JH2k00/BioSensorBox/README.md

# BioSensorBox
This repository contains the hardware and software for my project in the Advanced Topics in PCB Design lecture at the Technical University of Darmstadt
