JH2k00/BioSensorBox/biosensorbox/schematic_v11.pdf

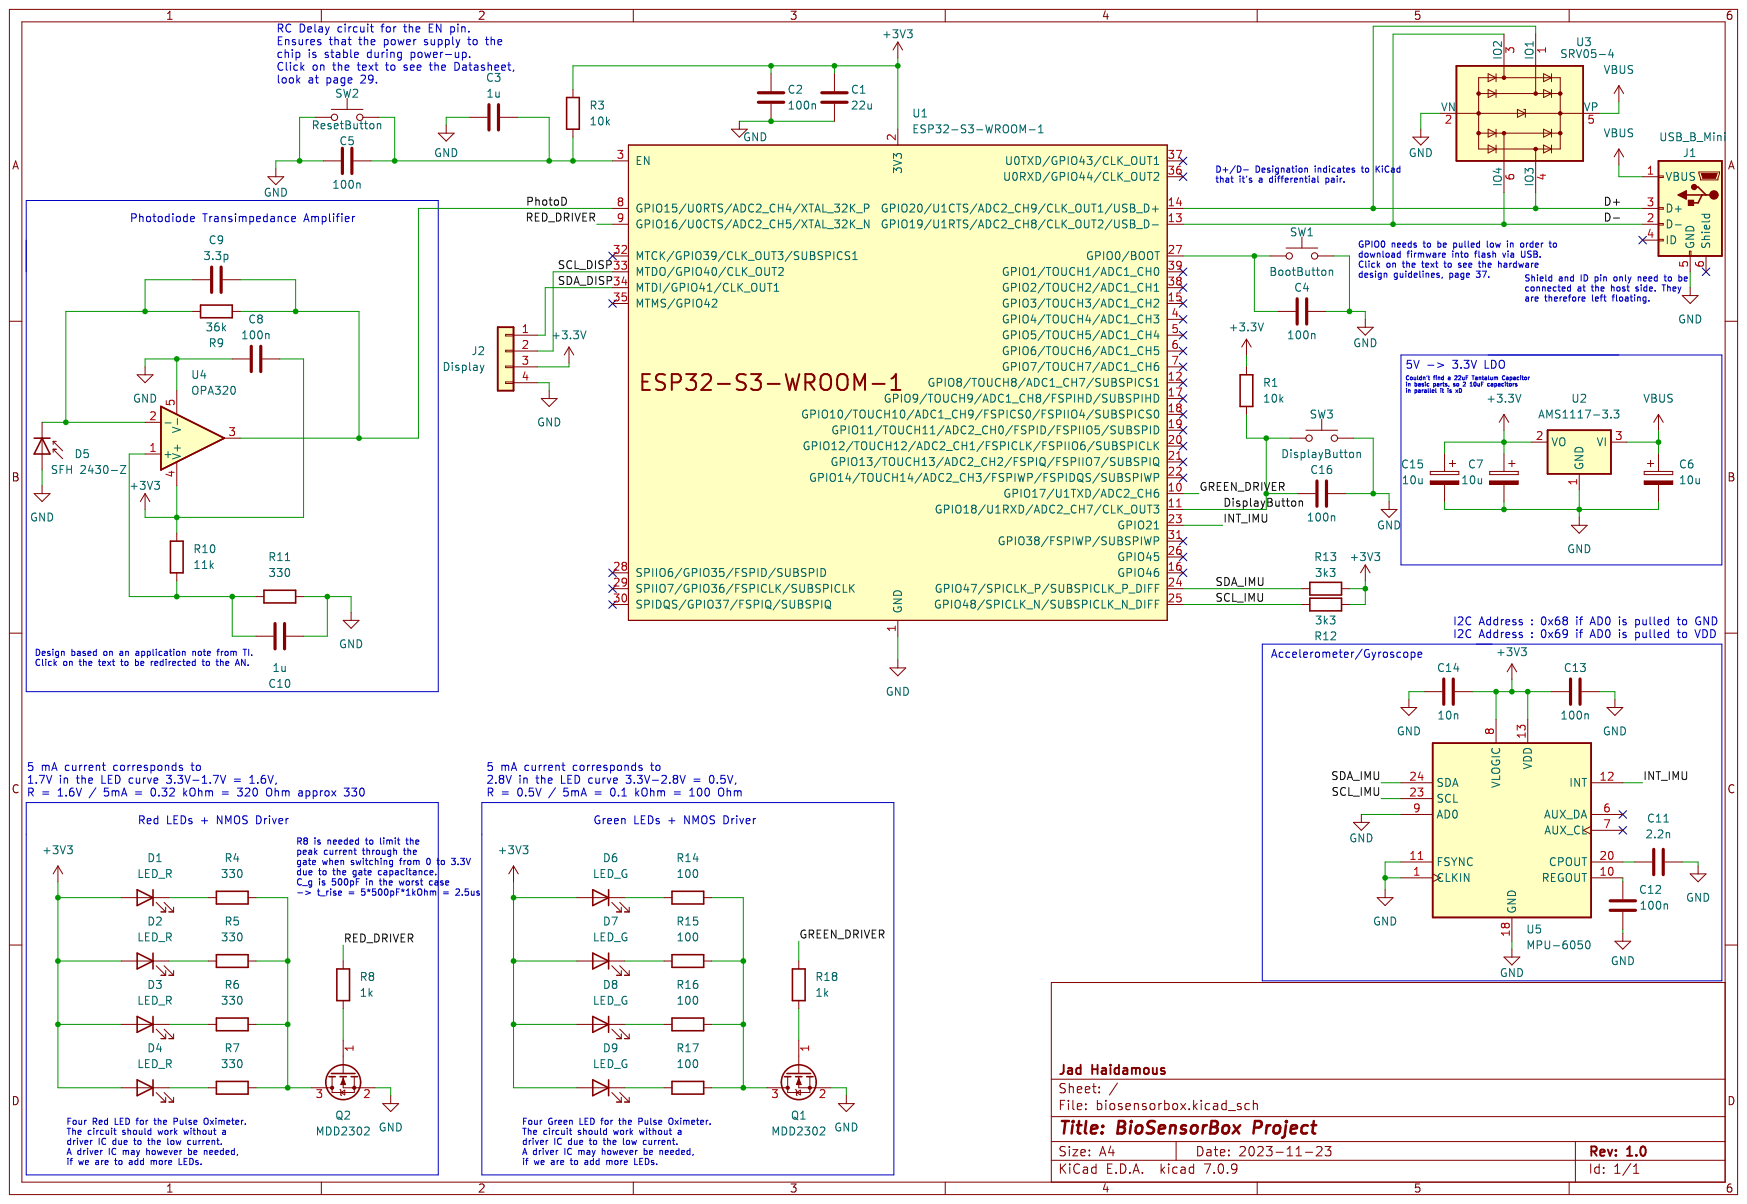
[picture p1: page 1]
