JH2k00/BioSensorBox/biosensorbox/schematic_v10.pdf

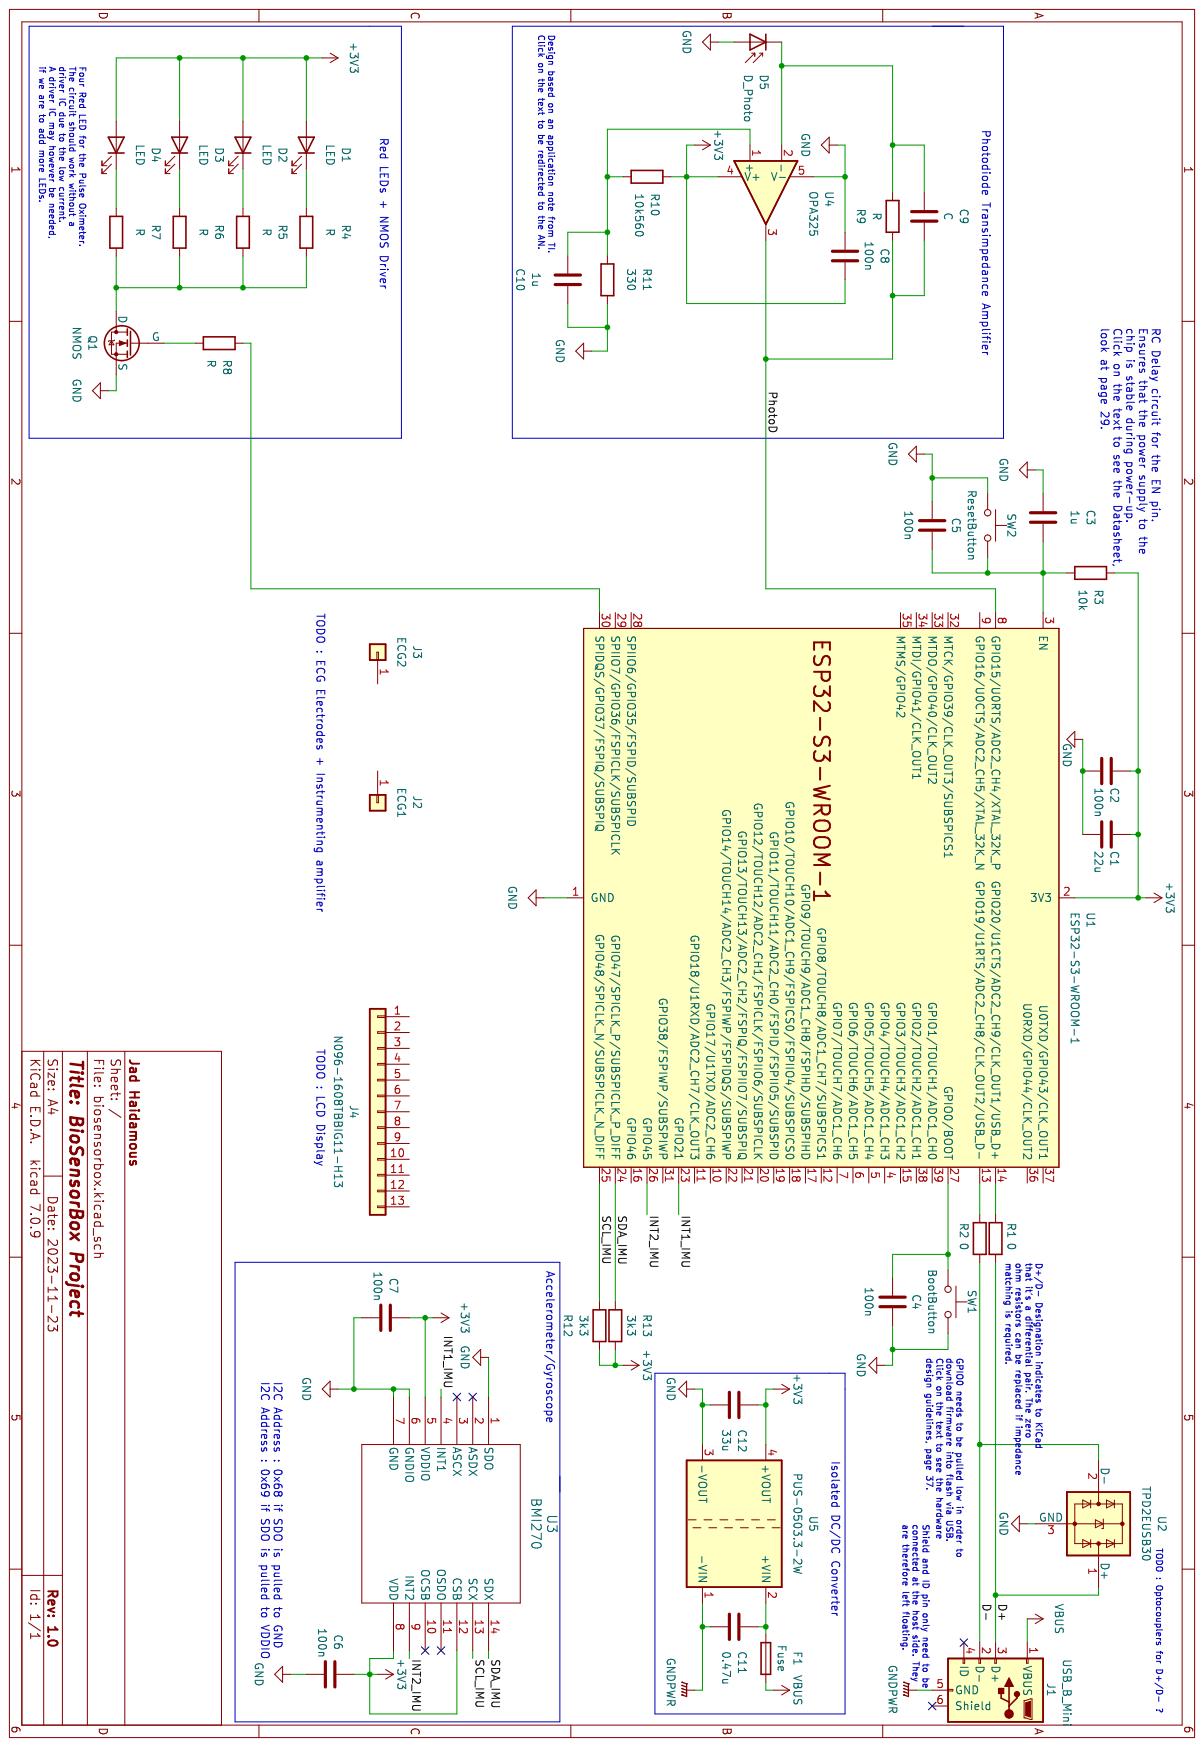
[picture p2: page 1]
