JH2k00/BioSensorBox/biosensorbox/biosensorbox.kicad_pcb

## KiCad design biosensorbox/biosensorbox.kicad_pcb (2024-02-05)

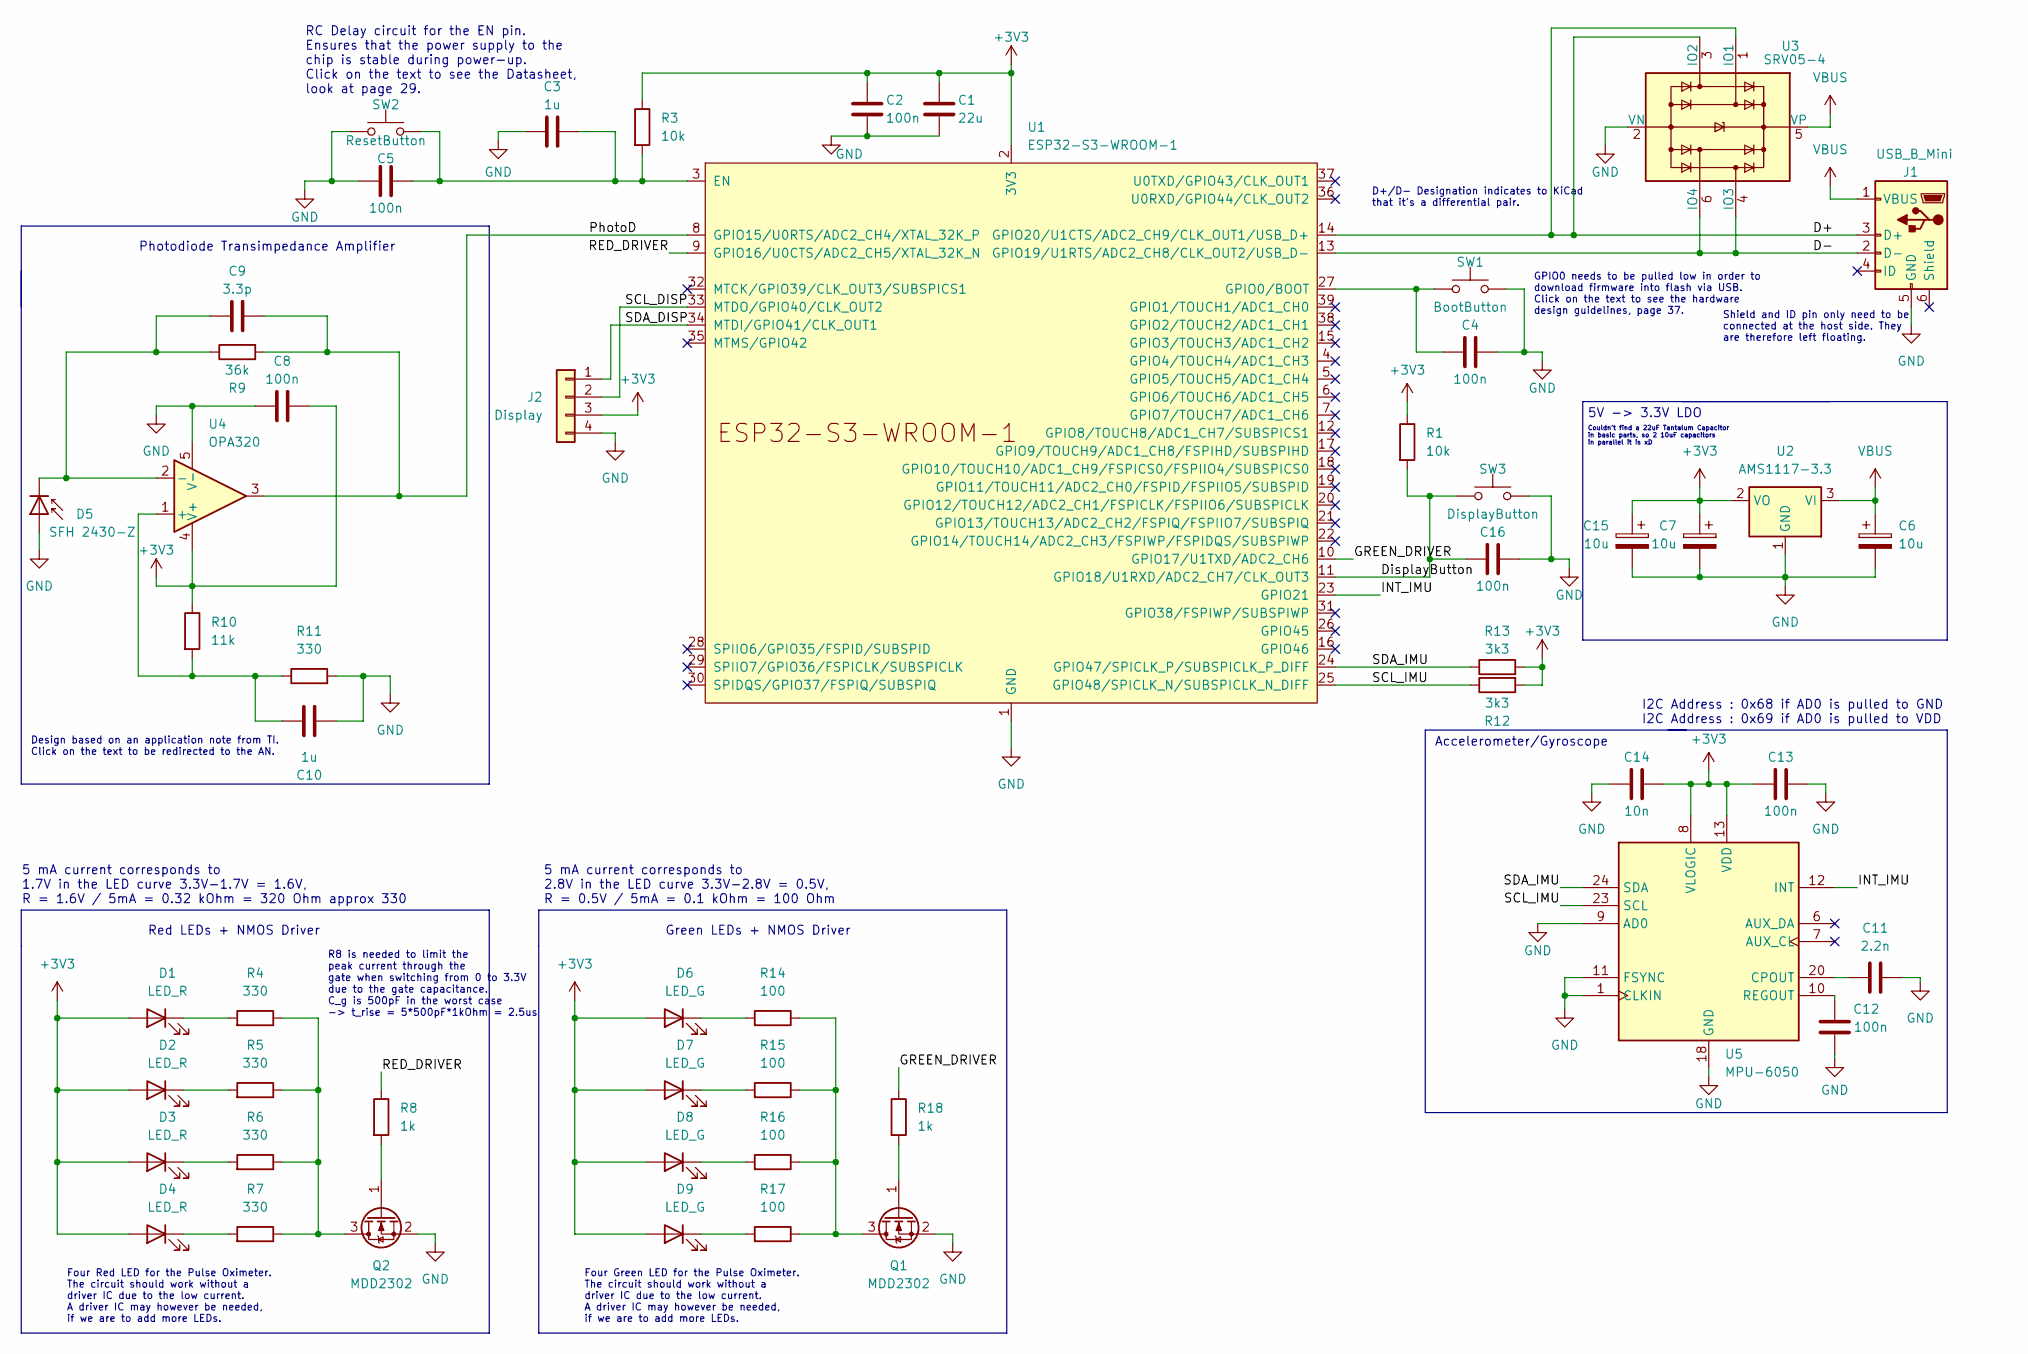
[picture p3: schematic biosensorbox.kicad_sch, BioSensorBox Project]

Parts:
C1: 22u; C_1206_3216Metric
C2, C4, C5, C8, C12, C13, C16: 100n; C_0603_1608Metric
C3, C10: 1u; C_0805_2012Metric
C6, C7, C15: 10u; CP_EIA-3216-18_Kemet-A
C9: 3.3p; C_0402_1005Metric
C11: 2.2n; C_0603_1608Metric
C14: 10n; C_0603_1608Metric
D1, D2, D3, D4: LED_R; LED_0603_1608Metric
D5: SFH 2430-Z; Osram_SFH2430
D6, D7, D8, D9: LED_G; LED_0603_1608Metric
J1: USB_B_Mini; USB_Mini-B_Wuerth_65100516121_Horizontal
J2: Display; PinHeader_1x04_P2.54mm_Vertical
Q1, Q2: MDD2302; SOT-23
R1, R3: 10k; R_0603_1608Metric
R4, R5, R6, R7, R11: 330; R_0603_1608Metric
R8, R18: 1k; R_0603_1608Metric
R9: 36k; R_0805_2012Metric
R10: 11k; R_0805_2012Metric
R12, R13: 3k3; R_0603_1608Metric
R14, R15, R16, R17: 100; R_0603_1608Metric
SW1: BootButton; SW_Push_1P1T_XKB_TS-1187A
SW2: ResetButton; SW_Push_1P1T_XKB_TS-1187A
SW3: DisplayButton; SW_Push_1P1T_XKB_TS-1187A
U1: ESP32-S3-WROOM-1
U2: AMS1117-3.3; SOT-223-3_TabPin2
U3: SRV05-4; SOT-23-6
U4: OPA320; SOT-23-5
U5: MPU-6050; InvenSense_QFN-24_4x4mm_P0.5mm

Connections:
+3V3: C1.1, C2.1, C7.1, C8.2, C13.1, C14.1, C15.1, D1.2 (A), D2.2 (A), D3.2 (A), D4.2 (A), D6.2 (A), D7.2 (A), D8.2 (A), D9.2 (A), J2.3, R1.1, R3.1, R10.1, R12.2, R13.2, U1.2 (3V3), U2.2 (VO), U4.4 (V+), U5.8 (VLOGIC), U5.13 (VDD)
/D+: J1.3 (D+), U1.14 (GPIO20/U1CTS/ADC2_CH9/CLK_OUT1/USB_D+), U3.1 (IO1), U3.3 (IO2)
/D-: J1.2 (D-), U1.13 (GPIO19/U1RTS/ADC2_CH8/CLK_OUT2/USB_D-), U3.4 (IO3), U3.6 (IO4)
/DisplayButton: C16.2, R1.2, SW3.2, U1.11 (GPIO18/U1RXD/ADC2_CH7/CLK_OUT3)
/GREEN_DRIVER: R18.1, U1.10 (GPIO17/U1TXD/ADC2_CH6)
/INT_IMU: U1.23 (GPIO21), U5.12 (INT)
/PhotoD: C9.2, R9.2, U1.8 (GPIO15/U0RTS/ADC2_CH4/XTAL_32K_P), U4.3
/RED_DRIVER: R8.1, U1.9 (GPIO16/U0CTS/ADC2_CH5/XTAL_32K_N)
/SCL_DISP: J2.2, U1.33 (MTDO/GPIO40/CLK_OUT2)
/SCL_IMU: R12.1, U1.25 (GPIO48/SPICLK_N/SUBSPICLK_N_DIFF), U5.23 (SCL)
/SDA_DISP: J2.1, U1.34 (MTDI/GPIO41/CLK_OUT1)
/SDA_IMU: R13.1, U1.24 (GPIO47/SPICLK_P/SUBSPICLK_P_DIFF), U5.24 (SDA)
GND: C1.2, C2.2, C3.1, C4.1, C5.1, C6.2, C7.2, C8.1, C10.2, C11.2, C12.2, C13.2, C14.2, C15.2, C16.1, D5.2 (A), J1.5 (GND), J1.6 (Shield), J2.4, Q1.2 (S), Q2.2 (S), R11.2, SW1.1, SW2.1, SW3.1, U1.1 (GND), U1.40 (GND), U1.41 (GND), U2.1 (GND), U3.2 (VN), U4.5 (V-), U5.1 (CLKIN), U5.9 (AD0), U5.11 (FSYNC), U5.18 (GND)
unnamed: D1.1 (K), R4.2
unnamed: D2.1 (K), R5.2
unnamed: D3.1 (K), R6.2
unnamed: D4.1 (K), R7.2
unnamed: C9.1, D5.1 (K), R9.1, U4.2 (-)
unnamed: D6.1 (K), R14.2
unnamed: D7.1 (K), R15.2
unnamed: D8.1 (K), R16.2
unnamed: D9.1 (K), R17.2
unnamed: Q1.3 (D), R14.1, R15.1, R16.1, R17.1
unnamed: Q1.1 (G), R18.2
unnamed: Q2.3 (D), R4.1, R5.1, R6.1, R7.1
unnamed: Q2.1 (G), R8.2
unnamed: C3.2, C5.2, R3.2, SW2.2, U1.3 (EN)
unnamed: C4.2, SW1.2, U1.27 (GPIO0/BOOT)
unnamed: C10.1, R10.2, R11.1, U4.1 (+)
unnamed: C11.1, U5.20 (CPOUT)
unnamed: C12.1, U5.10 (REGOUT)
VBUS: C6.1, J1.1 (VBUS), U2.3 (VI), U3.5 (VP)

Notes on the sheet:
Red LEDs + NMOS Driver
Four Red LED for the Pulse Oximeter. The circuit should work without a driver IC due to the low current. A driver IC may however be needed, if we are to add more LEDs.
Shield and ID pin only need to be connected at the host side. They are therefore left floating.
5 mA current corresponds to 1.7V in the LED curve 3.3V-1.7V = 1.6V, R = 1.6V / 5mA = 0.32 kOhm = 320 Ohm approx 330
D+/D- Designation indicates to KiCad that it's a differential pair.
Four Green LED for the Pulse Oximeter. The circuit should work without a driver IC due to the low current. A driver IC may however be needed, if we are to add more LEDs.
Couldn't find a 22uF Tantalum Capacitor in basic parts, so 2 10uF capacitors in parallel it is xD
5 mA current corresponds to 2.8V in the LED curve 3.3V-2.8V = 0.5V, R = 0.5V / 5mA = 0.1 kOhm = 100 Ohm
Design based on an application note from TI. Click on the text to be redirected to the AN.
I2C Address : 0x68 if AD0 is pulled to GND I2C Address : 0x69 if AD0 is pulled to VDD
GPIO0 needs to be pulled low in order to download firmware into flash via USB. Click on the text to see the hardware design guidelines, page 37.
5V -> 3.3V LDO
Photodiode Transimpedance Amplifier
Green LEDs + NMOS Driver
RC Delay circuit for the EN pin. Ensures that the power supply to the chip is stable during power-up. Click on the text to see the Datasheet, look at page 29.
Accelerometer/Gyroscope
R8 is needed to limit the peak current through the gate when switching from 0 to 3.3V due to the gate capacitance. C_g is 500pF in the worst case -> t_rise = 5*500pF*1kOhm = 2.5us

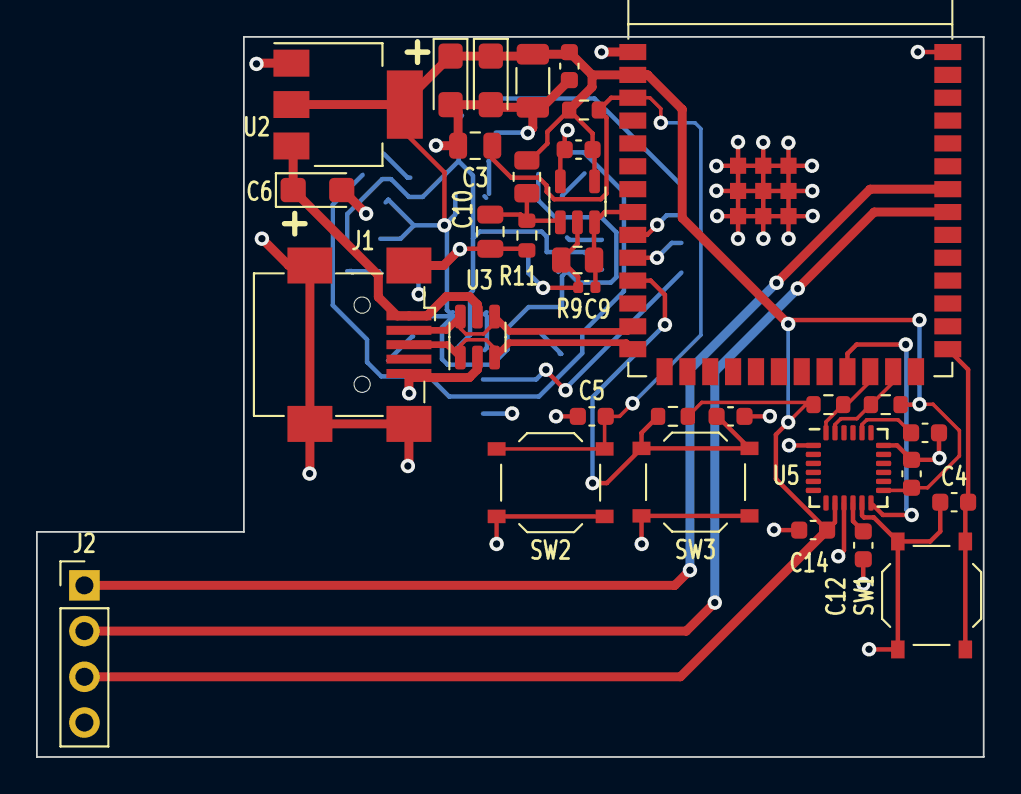
[picture p4: board biosensorbox.kicad_pcb from above]

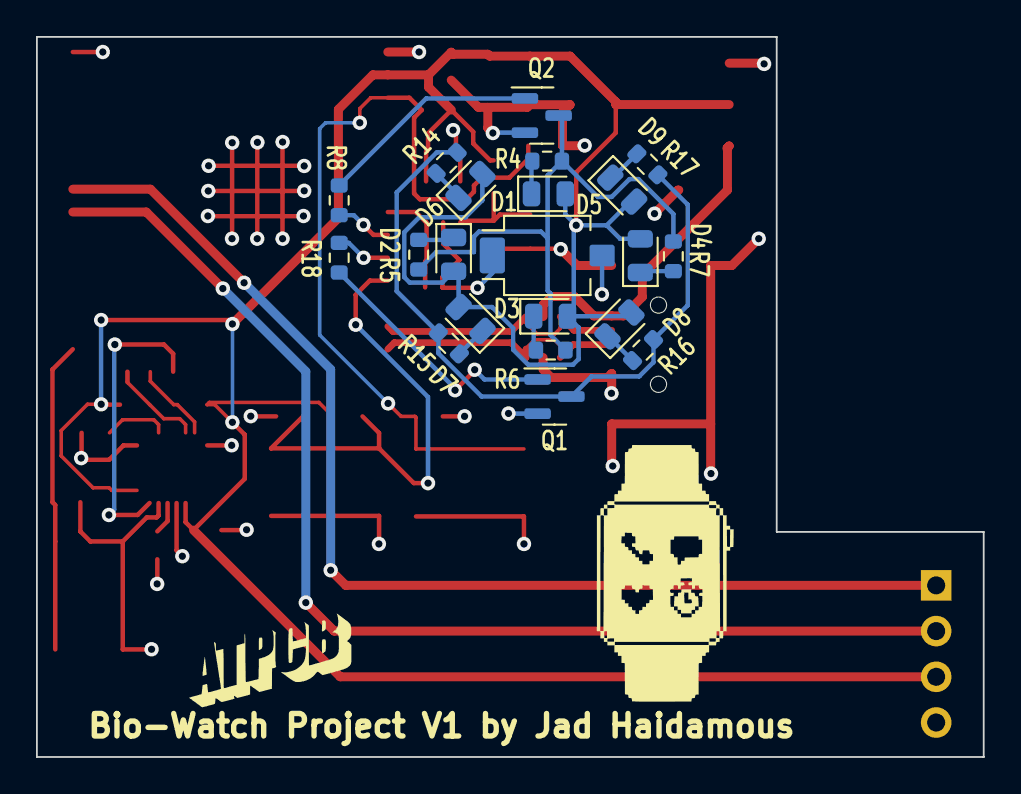
[picture p5: board biosensorbox.kicad_pcb from below]

Board: 4 copper layers, 52.6 x 40.0 mm, 54 parts (21 on the bottom side), 32 nets.
