JH2k00/BioSensorBox/(commit log)

2023-11-26 Almost finished first iteration of the schematic design
    [biosensorbox.kicad_pcb, biosensorbox.kicad_sch]
2023-11-26 Added pdf version of the current schematic
2023-11-27 Updated DC/DC Converter Capacitor values
    [biosensorbox.kicad_sch]
2023-12-16 Latest updates to the schematic
    [biosensorbox.kicad_sch]
2023-12-18 Finished Schematic and started Layout
    [biosensorbox.kicad_pcb, biosensorbox.kicad_sch]
2023-12-19 Finished layout and generated gerbers ! PCB is done !
    [BOM-biosensorbox.csv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]
2024-02-05 Updated to the newest version of the PCB
    [biosensorbox.kicad_pcb]
